hexa3/tinydie/hardware/docs/tinydie-schematic.pdf

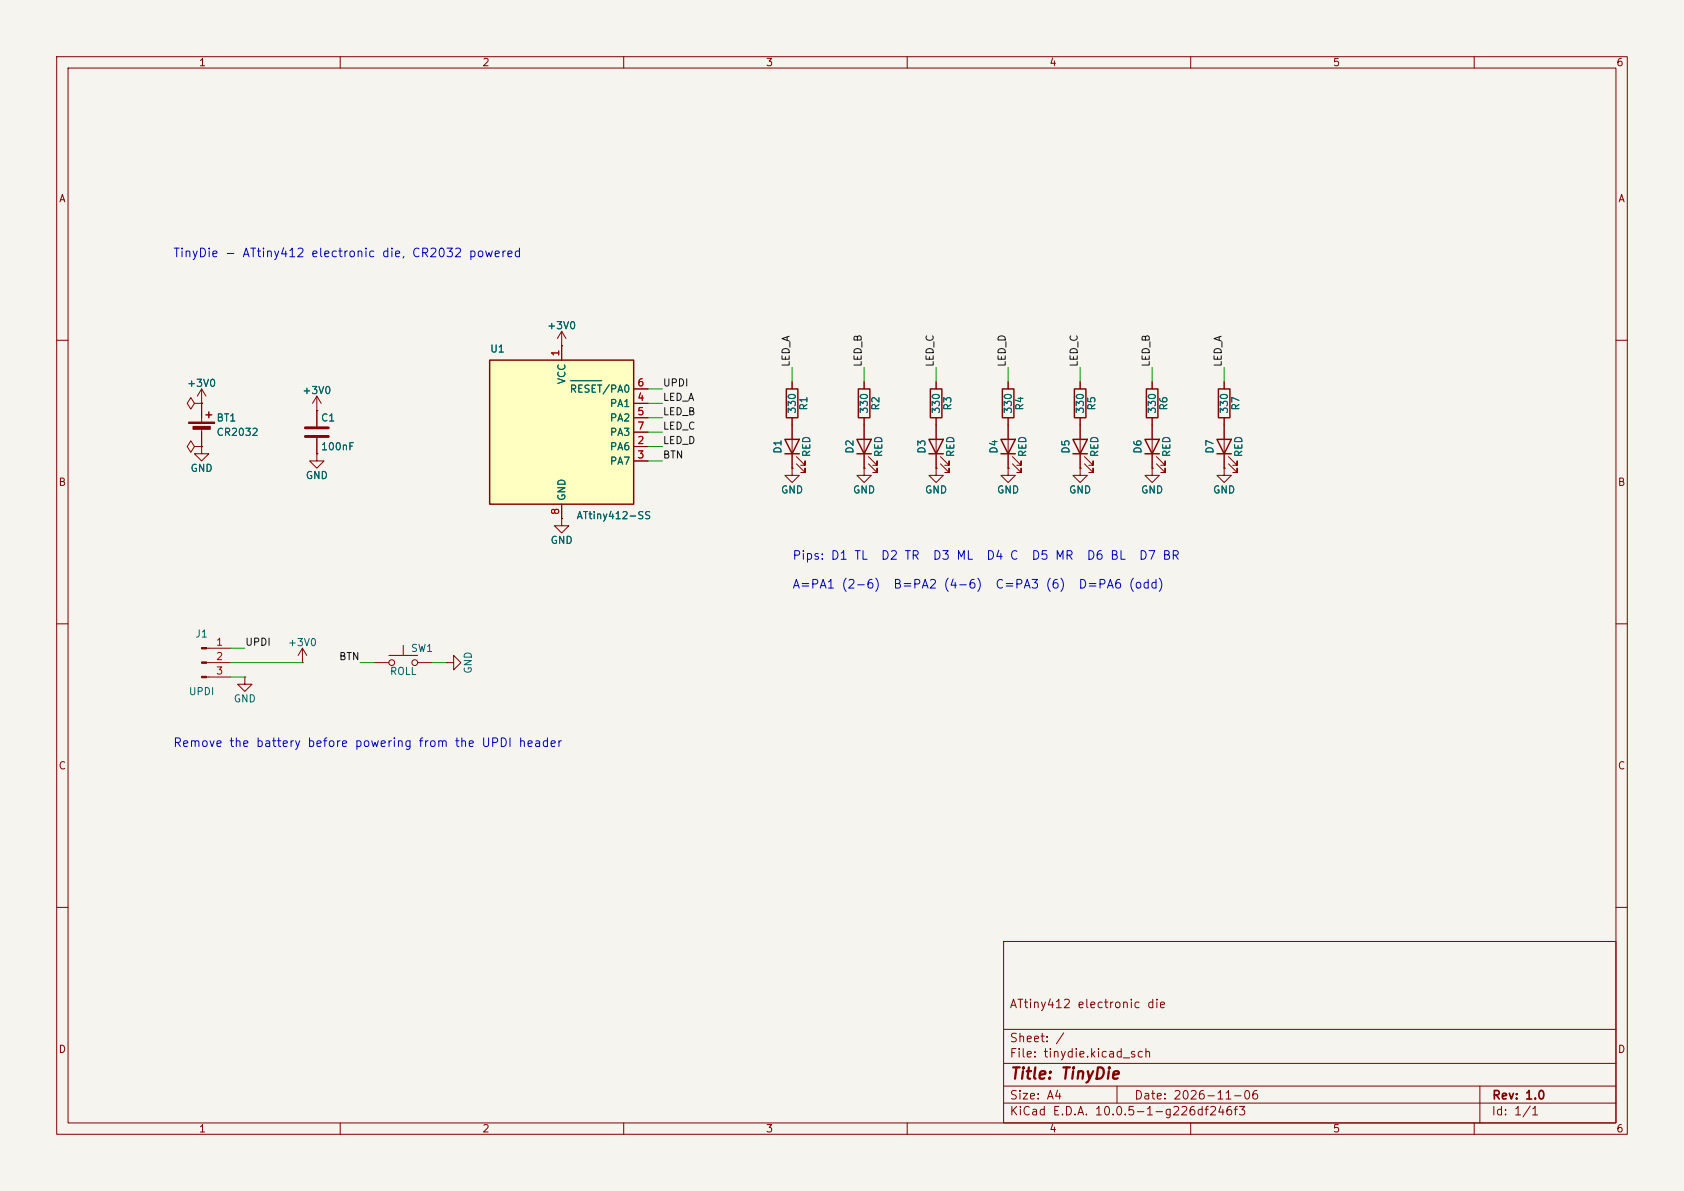
[picture p4: page 1]

TinyDie - ATtiny412 electronic die, CR2032 powered
100nF GND

8 GND +3V0 +3V0 +3V0 GND GND D2 RED D3 RED D4 RED 330 R4 330 R5 D5 RED 330 R1 GND D1 RED 330 R2 330 R3 330 R6 330 R7 D7 RED

Remove the battery before powering from the UPDI header C1

Pips: D1 TL D2 TR D3 ML D4 C D5 MR D6 BL D7 BR

Size: A4 | Rev: 1.0
KiCad E.D.A. 10.0.5-1-g226df246f3 | Id: 1/1
