hexa3/tinydie/hardware/tinydie.kicad_pcb

## KiCad design hardware/tinydie.kicad_pcb (2026-11-08)

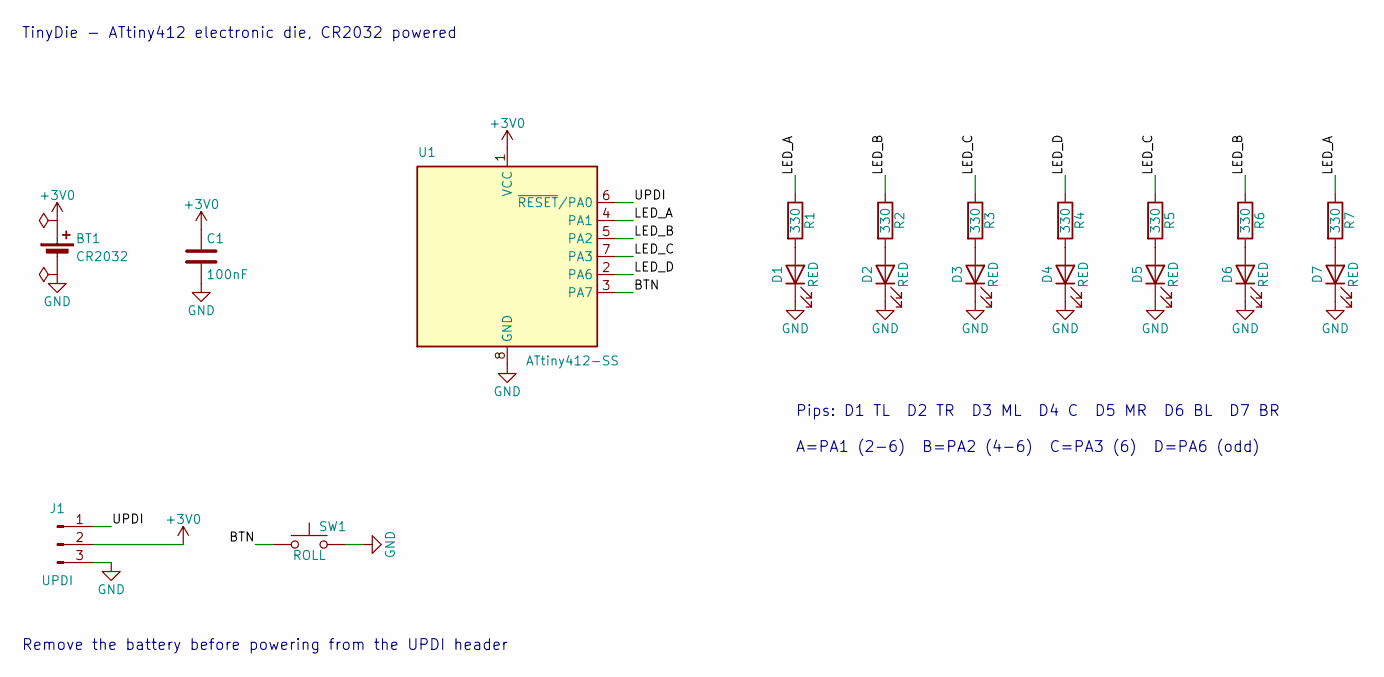
[picture p5: schematic tinydie.kicad_sch]

Parts:
BT1: CR2032; BatteryHolder_MYOUNG_BS-07-A1BJ001_CR2032; MPN MYOUNG BS-07-A1BJ001
C1: 100nF; C_0805_2012Metric_Pad1.18x1.45mm_HandSolder; MPN 0805 100nF X7R 16V (generic)
D1, D2, D3, D4, D5, D6, D7: RED; LED_0805_2012Metric_Pad1.15x1.40mm_HandSolder; MPN 0805 red LED, Vf~2.0V (generic)
J1: UPDI; PinHeader_1x03_P2.54mm_Vertical; MPN 1x3 2.54mm pin header (generic)
R1, R2, R3, R4, R5, R6, R7: 330; R_0805_2012Metric_Pad1.20x1.40mm_HandSolder; MPN 0805 330R 1% (generic)
SW1: ROLL; SW_PUSH_6mm; MPN 6x6mm THT tactile switch, 4-pin (generi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
U1: ATtiny412-SS; SOIC-8_3.9x4.9mm_P1.27mm; MPN Microchip ATTINY412-SSNR

Connections:
+3V0: BT1.1 (+), C1.1, J1.2, U1.1 (VCC)
/BTN: SW1.1, U1.3 (PA7)
/LED_A: R1.1, R7.1, U1.4 (PA1)
/LED_B: R2.1, R6.1, U1.5 (PA2)
/LED_C: R3.1, R5.1, U1.7 (PA3)
/LED_D: R4.1, U1.2 (PA6)
/UPDI: J1.1, U1.6 (~RESET/PA0)
GND: BT1.2 (-), C1.2, D1.1 (K), D2.1 (K), D3.1 (K), D4.1 (K), D5.1 (K), D6.1 (K), D7.1 (K), J1.3, SW1.2, U1.8 (GND)
unnamed: D1.2 (A), R1.2
unnamed: D2.2 (A), R2.2
unnamed: D3.2 (A), R3.2
unnamed: D4.2 (A), R4.2
unnamed: D5.2 (A), R5.2
unnamed: D6.2 (A), R6.2
unnamed: D7.2 (A), R7.2

Notes on the sheet:
TinyDie - ATtiny412 electronic die, CR2032 powered
Pips: D1 TL D2 TR D3 ML D4 C D5 MR D6 BL D7 BR
A=PA1 (2-6) B=PA2 (4-6) C=PA3 (6) D=PA6 (odd)
Remove the battery before powering from the UPDI header

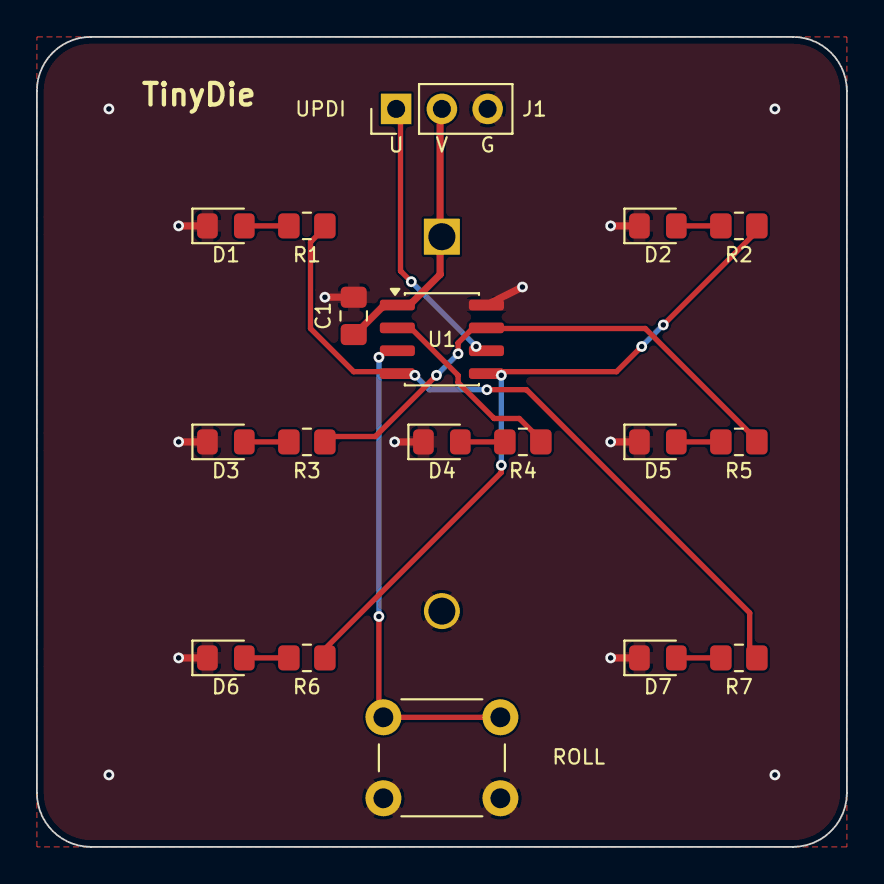
[picture p6: board tinydie.kicad_pcb from above]

Board: 2 copper layers, 45.0 x 45.0 mm, 19 parts (1 on the bottom side), 15 nets.
